DougLep/DIYClimateControl/Readme.txt

See DIYClimateControl.com for more information
Doug.Leppard@teralign.com
