DougLep/DIYClimateControl/Eagle files/AC Project thru hole V 1.02.brd

## EAGLE design Eagle files/AC Project thru hole V 1.02.brd (2014-07-21)

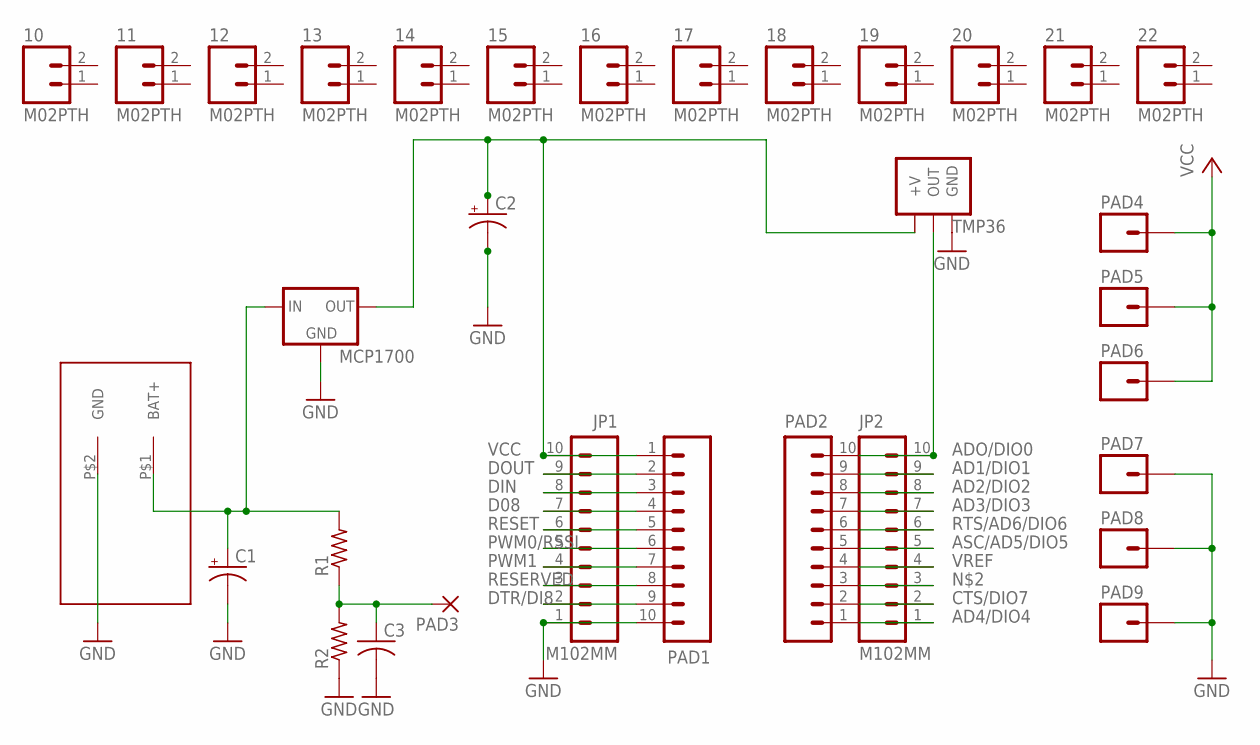
[picture p1: schematic AC Project thru hole V 1.02.sch]

Parts:
10, 11, 12, 13, 14, 15, 16, 17, 18, 19, 20, 21, 22: M02PTH; 1X02
C1, C2: CPOL-USE1.8-4; E1,8-4
C3: C-US050-030X075; C050-030X075
JP1, JP2: M102MM; 1X10-2MM
MCP1700: MCP1700INLINE; TO92-INLINE
PAD1, PAD2: M10"; 1X10
PAD3: 1,6/0,8
PAD4, PAD5, PAD6, PAD7, PAD8, PAD9: M01PTH; 1X01
R1, R2: R-US_0207/10; 0207/10
TMP36: TMP36INLINE; TO92-INLINE
U$2: AAA_3X_HOLDERAAA_3X_HOLDER_THROUGH_HOLE; AAA_3X_HOLDER

Connections:
AD1/DIO1: JP2.9, PAD2.9
AD2/DIO2: JP2.8, PAD2.8
AD3/DIO3: JP2.7, PAD2.7
AD4/DIO4: JP2.1, PAD2.1
ADO/DIO0: JP2.10, PAD2.10, TMP36.2 (OUT)
ASC/AD5/DIO5: JP2.5, PAD2.5
CTS/DIO7: JP2.2, PAD2.2
D08: JP1.7, PAD1.4
DIN: JP1.8, PAD1.3
DOUT: JP1.9, PAD1.2
DTR/DI8: JP1.2, PAD1.9
GND: C1.-, C2.-, C3.2, JP1.1, MCP1700.1 (GND), PAD1.10, PAD7.1, PAD8.1, PAD9.1, R2.1, TMP36.3 (GND), U$2.P$2 (GND)
unnamed: C1.+, MCP1700.2 (IN), R1.2, U$2.P$1 (BAT+)
unnamed: JP2.3, PAD2.3
unnamed: C3.1, PAD3.1, R1.1, R2.2
PWM0/RSSI: JP1.5, PAD1.6
PWM1: JP1.4, PAD1.7
RESERVED: JP1.3, PAD1.8
RESET: JP1.6, PAD1.5
RTS/AD6/DIO6: JP2.6, PAD2.6
VCC: C2.+, JP1.10, MCP1700.3 (OUT), PAD1.1, PAD4.1, PAD5.1, PAD6.1, TMP36.1 (+V)
VREF: JP2.4, PAD2.4

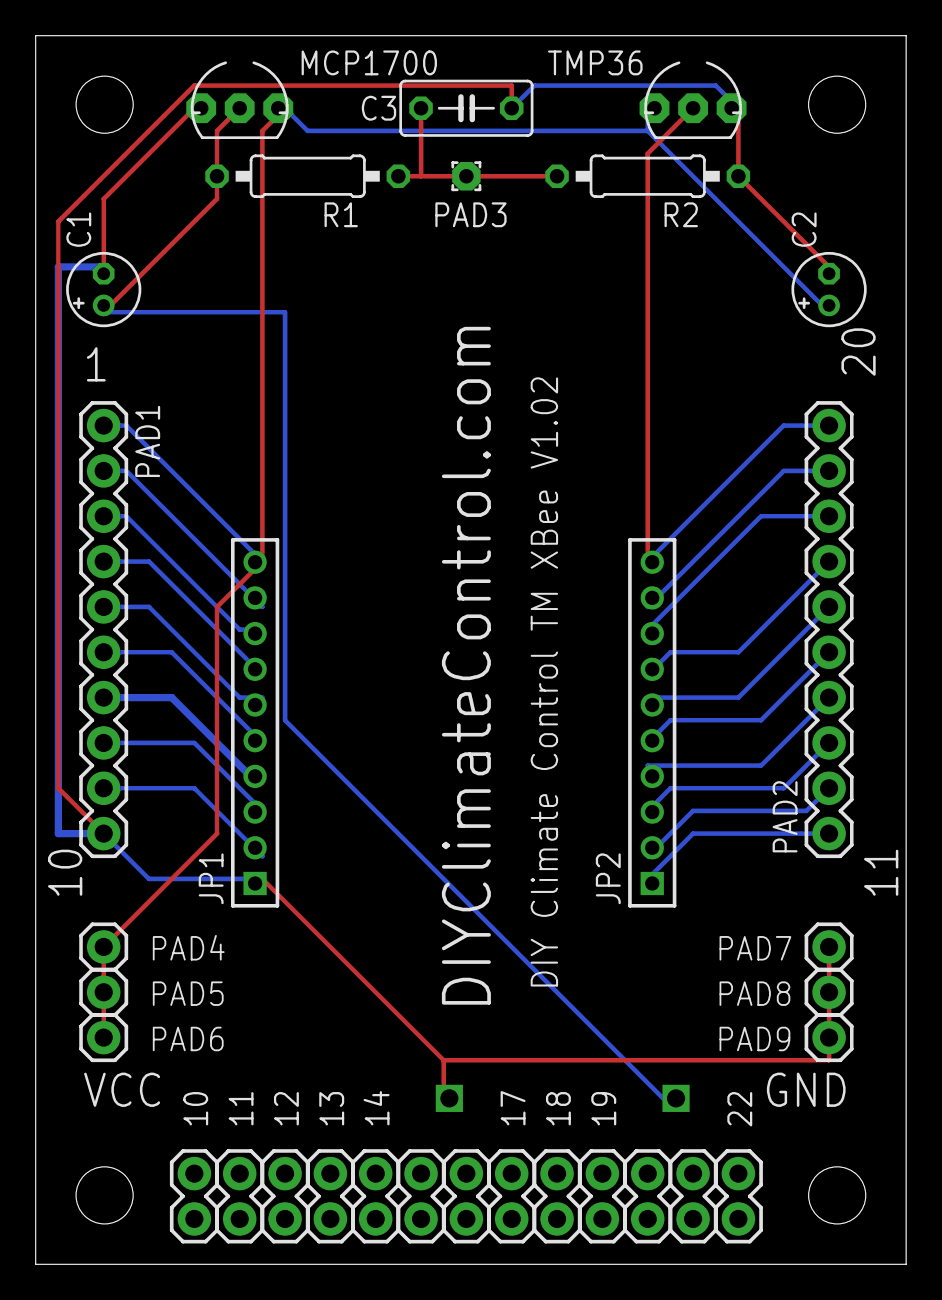
[picture p2: board AC Project thru hole V 1.02.brd from above]

Board: 2 copper layers, 48.8 x 68.8 mm, 32 parts (1 on the bottom side), 22 nets.
